john-cabaj/VGA_Driver/(list of files, cad)

Other CAD files:
miniproject_2/work/display_plane/verilog.psm
miniproject_2/work/rom_test/verilog.psm
miniproject_2/work/t_display_plane/verilog.psm
miniproject_2/work/t_timing_generator/verilog.psm
miniproject_2/work/timing_generator/verilog.psm
miniproject_2/work/top_level/verilog.psm
