john-cabaj/VGA_Driver/miniproject_2/work/rom/_primary.vhd

library verilog;
use verilog.vl_types.all;
entity rom is
    port(
        pixel_out       : out    vl_logic_vector(23 downto 0);
        addr            : in     vl_logic_vector(12 downto 0);
        clk             : in     vl_logic;
        rst             : in     vl_logic
    );
end rom;
