john-cabaj/VGA_Driver/miniproject_2/work/vga_logic/_primary.vhd

library verilog;
use verilog.vl_types.all;
entity vga_logic is
    port(
        clk             : in     vl_logic;
        rst             : in     vl_logic;
        fifo_empty      : in     vl_logic;
        pixel_in        : in     vl_logic_vector(23 downto 0);
        blank           : out    vl_logic;
        comp_sync       : out    vl_logic;
        hsync           : out    vl_logic;
        vsync           : out    vl_logic;
        red             : out    vl_logic_vector(7 downto 0);
        green           : out    vl_logic_vector(7 downto 0);
        blue            : out    vl_logic_vector(7 downto 0)
    );
end vga_logic;
