john-cabaj/VGA_Driver/miniproject_2/rom_test.v

module rom_test(output reg [23:0] pixel_out, input [12:0] addr, input clk, rst);
    
    reg [23:0] rom[0:4799];
    
    initial begin
       $readmemh("rom_img.coe", rom); 
    end
    
    /*always@(posedge clk) begin
        if(clk) begin
            if((addr >= 13'd0) && (addr < 13'd4800)) begin
                  pixel_out = rom[addr];
            end
        end
    end*/
    
    always@(addr) begin
       if((addr >= 13'd0) && (addr < 13'd4800)) begin
          pixel_out = rom[addr];
       end
    end
    
endmodule
